Scafir/gf180mcu-project-trident-gf180-teststructure/README.md

<!-- SPDX-FileCopyrightText: 2026 CERN
<!-- SPDX-License-Identifier: CC-BY-4.0 -->

# trident-gf180-teststructures

The aim of this ASIC is to implement teststructures to experimentally measure
leakage for various basic teststructures such as (but not limited to):
* transistors
* MIM capacitors
* ESD protection pads

You can find the datasheet of this chip under `doc/TRIDENT_GF180_teststructures.pdf`.

You may find the upstream location of this repository, as well as others concerning
this ASIC at https://cern.ch/gftrid

ESD protection pads from liplib have been used, available here:
https://github.com/Scafir/liplib

This is an ASIC made through a CERN+JKU PhD collaboration.
