Scafir/gf180mcu-project-trident-gf180-teststructure/doc/figures/BondingDiagramStaggeredv2.png

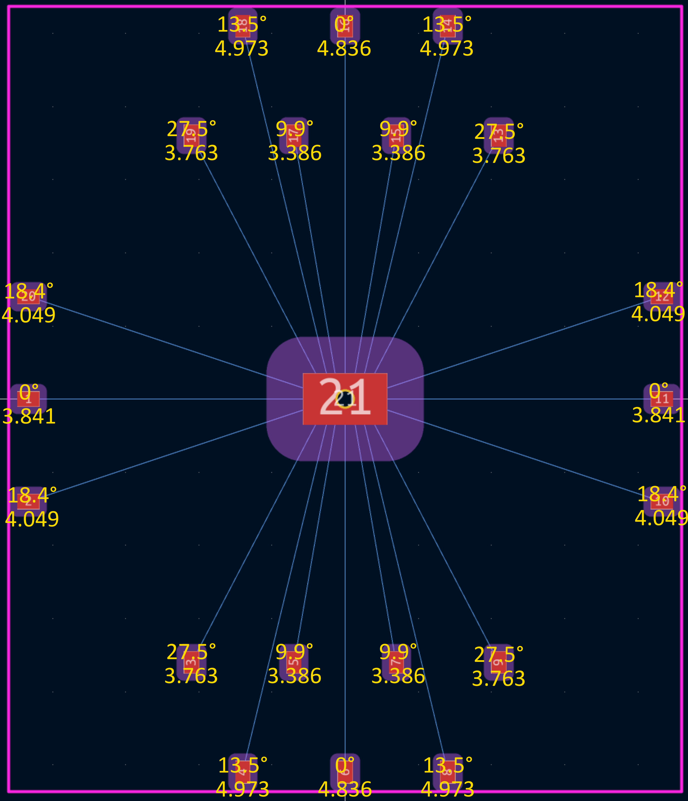
doc/figures/BondingDiagramStaggeredv2.png
