Scafir/gf180mcu-project-trident-gf180-teststructure/doc/TRIDENT_GF180_teststructures.pdf

30 June 2026

## TRIDENT-GF180-TESTSTRUCTURES Datasheet

## 1 Known issues

1. The markings of pin 100, pin 1 and pin 2 are incorrect. Pin 100 marking is actually pin 99. Pin 1 marking is pin 100. Pin 2 marking is pin 1.

## 2 Applications

- Leakage evaluation of GlobalFoundries GF180MCU (gf180mcuD) 180 nm process
- Evaluation of guard-trace effectiveness
- Evaluation of foundry vs. custom guarded ESD pad approaches for ultra-low current measurement
- Characterization of discrete HV/LV NFET and PFET leakage under guarding
- Characterization of MIM capacitor leakage and perimeter effects
- Evaluation of picoampere two-transistor charge-pump / current generator structure

## 3 Description

TRIDENT-GF180-TESTSTRUCTURES is a dedicated test ASIC to assess feasibility of ultralow current (pA and below) measurements in gf180mcuD. It is available open source here. (https://github.com/Scafir/gf180mcu-project-trident-gf180-teststructure) The primary metric is control and predictability of leakage current from “hot” measurement nodes. Primary leakage paths of interest are ESD protection networks, transistor, MIM capacitor, and leakage through insulator mitigated by driven guards.
Pins between structures are often interleaved, to allow for the neighboring pins to be driven as guard. This is especially useful when large voltage between pins are expected on the same device, such as the MIM capacitors.

## 4 Block Diagram

ACCURATE 2A | CERN HSE-RP-IL

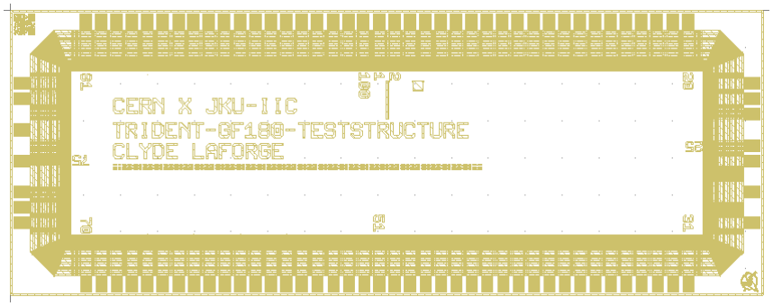
[picture p7: figure]

Figure 1: Top level view of the chip

## 5 Pin Configuration and Function Descriptions

# Pin name | Decription

1 MC MAX P1 | MIM capacitor, max perimeter, terminal P1
2 MC MIN P2 | MIM capacitor, min perimeter, terminal P2
3 MC MIN P1 | MIM capacitor, min perimeter, terminal P1
4–7 UNUSED | Do not connect
8 MC GUARD P2 | Guard for MIM capacitor terminal P2
9–13 UNUSED | Do not connect
14 GL TOP | Guard leakage structure, top guard
15 GL BOT | Guard leakage structure, bottom guard
16 GL SIDE | Guard leakage structure, side guard
17 GL HOT | Guard leakage structure, hot node
18 GL PAD GUARD | Guard leakage structure, guard of hot bondpad
19 VSS | Ground supply
20 VDD | Positive supply
21 PESD GS HOTN | Pad ESD (guard+sense), inverted hot output
22 PESD GS SENSEN Pad ESD (guard+sense), inverted sense output
23 PESD GS SENSE | Pad ESD (guard+sense), sense input
24 NO BOND | No bondpad present, do not bond
25 PESD GS HOT | Pad ESD (guard+sense), hot input
26 NO BOND | No bondpad present, do not bond
27 PESD G HOTN | Pad ESD (guard), inverted hot output
28 NO BOND | No bondpad present, do not bond
29 PESD G HOT | Pad ESD (guard), hot input
30 PESD GUARD | Guard for all PESD structures
31 VSS | Ground supply
32 VDD | Positive supply

33–48 UNUSED | Do not connect
49 DESD VDD K | Discrete ESD diodes to VDD, cathode
50 DESD VSS K | Discrete ESD diodes to VSS, cathode
51 DESD VDD A | Discrete ESD diodes to VDD, anode
52 DESD GUARD | Guard for discrete ESD diode structures
53 VSS | Ground supply
54 VDD | Positive supply
55 TR GUARD | Transistor structures, guard (common)
56 TR HP D | High-voltage PFET, drain
57 TR HP G | High-voltage PFET, gate
58 TR HP S | High-voltage PFET, source
59 TR HN D | High-voltage NFET, drain
60 TR HN G | High-voltage NFET, gate
61 TR HN S | High-voltage NFET, source
62 TR LP D | Low-voltage PFET, drain
63 TR LP G | Low-voltage PFET, gate
64 TR LP S | Low-voltage PFET, source
65 TR LN D | Low-voltage NFET, drain
66 TR LN G | Low-voltage NFET, gate
67 TR LN S | Low-voltage NFET, source
68 TR GUARD | Transistor structures, guard (common)
69 VSS | Ground supply
70 VDD | Positive supply
71 PL GUARD | Pad leakage structure, guard (common)
72 PL FLOAT | Pad leakage structure, floating pad
73 PL GS SENSE | Pad leakage (guard+sense), sense input
74 NO BOND | No bondpad present, do not bond
75 PL GS HOT | Pad leakage (guard+sense), hot input
76 NO BOND | No bondpad present, do not bond
77 PL G HOT | Pad leakage (guard), hot input
78 NO BOND | No bondpad present, do not bond
79 PL A HOT | Pad leakage (analog), hot input
80 PL GUARD | Pad leakage structure, guard (common)
81 VSS | Ground supply
82 VDD | Positive supply
83 CP GUARD | Charge pump structure, guard
84 CP G2 | Charge pump, gate 2
85 CP VS | Charge pump, VS node (drain+source)
86 CP G1 | Charge pump, gate 1
87 CP VW | Charge pump, VW node (bulk)
88–96 UNUSED | Do not connect
97 VSS | Ground supply
98 VDD | Positive supply
99 MC GUARD P1 | Guard for MIM capacitor terminal P1

100 MC MAX P2 | MIM capacitor, max perimeter, terminal P2

UNUSED pads are foundry-provided analog ESD pad with their output left unconnected. NO BOND pads have not actual bondpad implemented. They are missing due to the underlying structures being too large. Instead of simply removing them from lists, they are kept nonetheless so that the pad positions and numbering stays regular.

## 6 ESD protection pads

### 6.1 Foundry provided analog pad

Below is a diagram of the foundry provided analog input pad, which provide a classic protection structure. The input diodes (on the pad side) are very large as they are supposed to take the brunt of the ESD pulses. The series resistor and output diodes are optional: they are not provided within the pad itself, but users are encouraged to add them in the documentation. The value of the series resistor is typically a few hundred ohms. This allow a secondary path for the current in case of an ESD spike, and the series resistor allows for a reduction of the voltage to which the core will be exposed.
This pad has an implementation with no output, to characterize its leakage in ADDREF. It does not have an implementation with output connected to an inverted to determine its capability of protecting the core transistors due to a lack of time during the layout process.

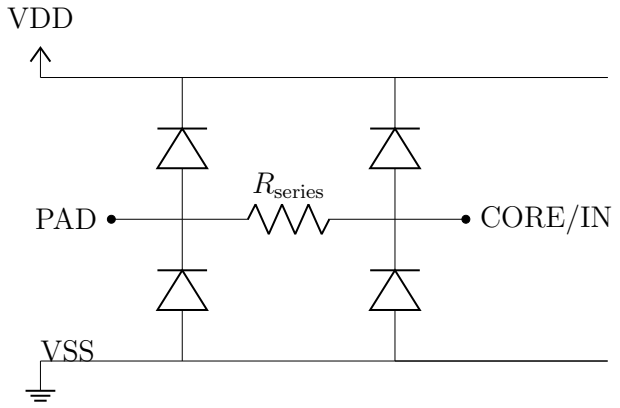
[picture p8: figure]
VDD; VSS; PAD; Rseries; CORE/IN

### 6.2 Custom guard pad

This adds a guard trace around the input trace. This allows for the internal diodes (between PAD and GUARD) to experience a near zero voltage drop, and hence have minimal leakage. The guard voltage could be driven by a buffer connected to the core voltage. It could also be driven independently from the input (if it is at a fixed voltage), and trimmed by-device for a specific operating point, likely temperature.
In order to provide somewhat comparable ESD protection to the foundry provided analog pad, the size of each diode is doubled compared to it.
As the inner VSS diode is not connected directly to VSS, it is necessary to put it in a deep N-well.

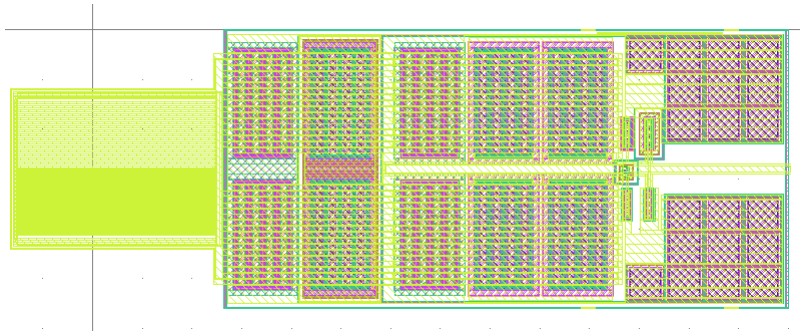
[picture p9: figure]

Figure 2: A graphic representation of the layout of the custom guard pad

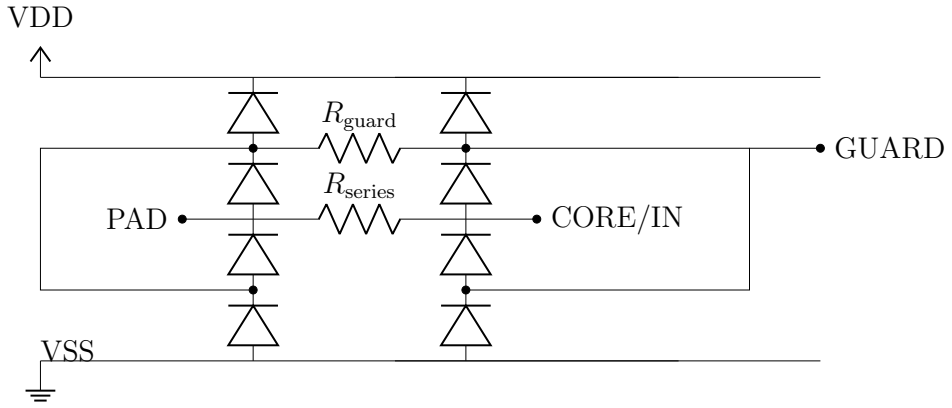
[picture p10: figure]
VDD; VSS; PAD; Rseries; CORE/IN; Rguard; GUARD

### 6.3 Custom guardsense pad

The custom guardsense pad goes one step further than the custom guarded pad. It duplicates the internal components (zero-voltage drop diodes and series resistor), and hence provide 2 new ports, named ”SENSE” and ”CORE SENSE”. Because the implementation of the sense and pad is fully symmetric and interleaved, any leakage experience on the PAD line should be the same on the sense line, provided minimal voltage drop on the series resistor.
This allows for sensing the leakage of the pad input from the core sense. In turn, a the guard voltage can be dynamically adjusted for zero leakage.
For the layout, it was necessary to implement custom ESD diodes, so that it was possible to interleave the guard and hot signals.

### 6.4 Custom no ESD guarded pad

This is simply a bond pad with a guarded metal output. No device whatsoever are connected to the input, which means that it has no ESD protection, but also minimal leakage on its own.

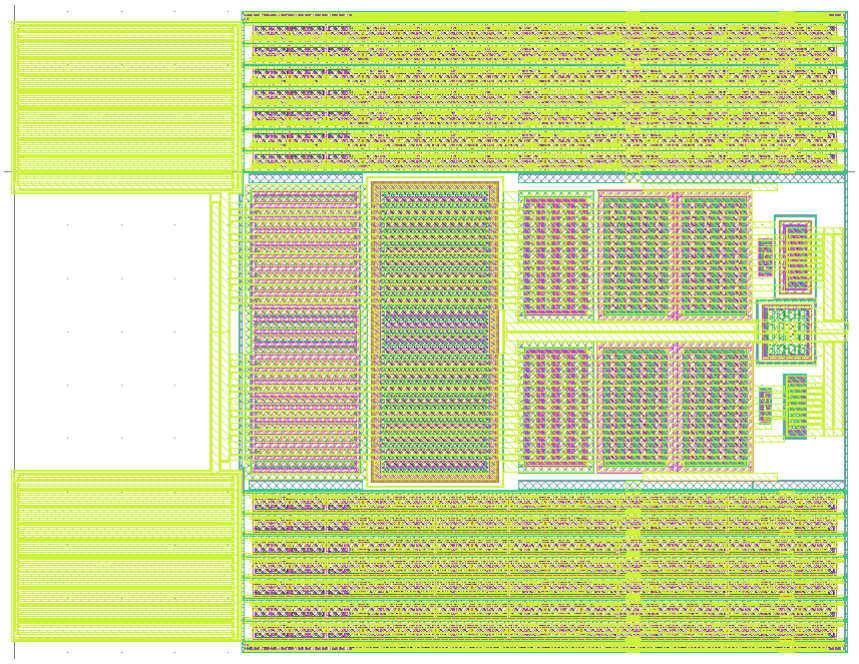
[picture p11: figure]

Figure 3: A graphic representation of the layout of the custom guardsense pad

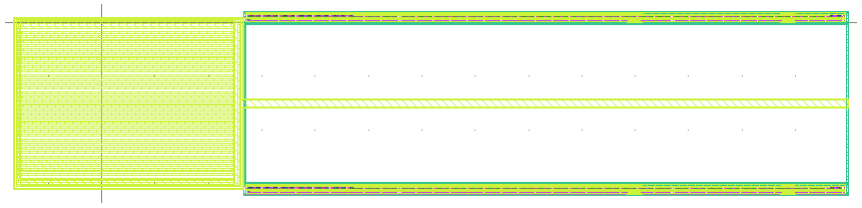
[picture p12: figure]

Figure 4: A graphic representation of the layout of the custom no esd pad

This pad is used anytime there is a device characterization pin, so that the measurement correspond to the actual device, and not the ESD protection circuitry. In order to comply with antenna rules, it has sometime been necessary to route the signal up and down to upper metal layers to comply with antenna rules. An unconnected custom no ESD guarded pad is implemented in 7.9, such that it will be possible to have a reference to other measurements.

## 7 Device Descriptions (by Device)

### 7.1 MIMCAP MAX PERIM

### 7.1.1 Description

MIM capacitor of (256 × 16µm and 8192 fF). Its high perimeter geometry is to study the effect of perimeter in the MIM capacitor leakage. It will be compared against 7.2.

### 7.1.2 Pins (array)

#99, Guard

#100 Pin 2

#1 Pin 1

Pin 1 connects to the lower plate, pin 2 to the upper plate.

### 7.1.3 Diagram

Pin 1

Pin 2

Guard | CMIM ≈ 8192 fF

Figure 5: MIM capacitor (MAX PERIM) with guard.

### 7.2 MIMCAP MIN PERIM

### 7.2.1 Description

MIM capacitor of (64 × 64µm and 8192 fF). Its minimal perimeter geometry is to study the effect of perimeter in the MIM capacitor leakage. It will be compared against 7.1.

### 7.2.2 Pins (array)

#2 Pin 2

#3 Pin 1

#4 Guard

Pin 1 connects to the lower plate, pin 2 to the upper plate.

### 7.2.3 Diagram

Pin 1

Pin 2

Guard | CMIM ≈ 8192 fF

Figure 6: MIM capacitor (MIN PERIM) with guard.

### 7.3 GUARD LEAKAGE

### 7.3.1 Description

This is a guarded line of 1041 × 3 µm in metal XXX. It is guarded independently on the top, bottom and sides. These guard planes can be swept in relation to the hot so that the influence of guarding in silicon can be measured.

### 7.3.2 Pins (array)

#14 Top guard plane

#15 Bottom guard plane

#16 Side guard traces

#17 Hot

#18 Guard of the hot bondpad

### 7.3.3 Diagram

Top guard

Side guard

Hot

Bottom guard

### 7.4 PAD ESD GUARDSENSE

### 7.4.1 Description

Evaluate guard+sense approach and the ability to trim guard voltage using sense leakage. See 6.3 for details on the internal of the guardsense pad. The purpose of the inverters is to measure up to what sort of ESD pulse the gate of the internal low voltage transistors making up the inverters can survive.

### 7.4.2 Pins (array)

#21 Inverted hot output

#22 Inverted sense output

#23 Sense input

#25 Hot input

#30 Guard

### 7.4.3 Diagram

VDD

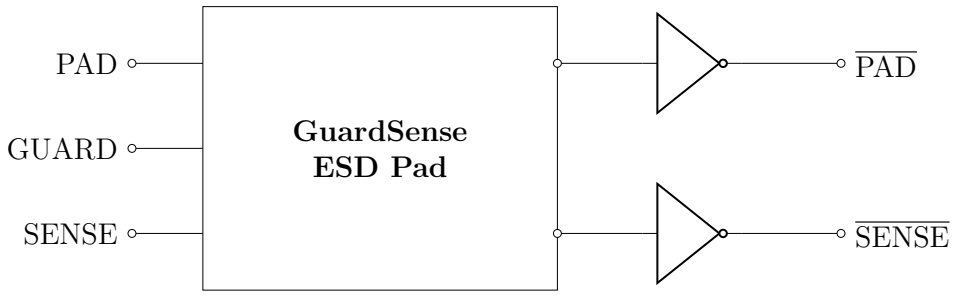
[picture p13: figure]
GuardSense ESD Pad; PAD; SENSE; GUARD

VSS

### 7.5 PAD ESD GUARD

### 7.5.1 Description

Baseline custom guarded ESD pad without sense line. The purpose of the inverter is to evaluate the robustness of the internal low-voltage inverter gate under ESD stress at the pad input.

### 7.5.2 Pins (array)

#27 Inverted hot output

#29 Hot input

#30 Guard

### 7.5.3 Diagram

VDD

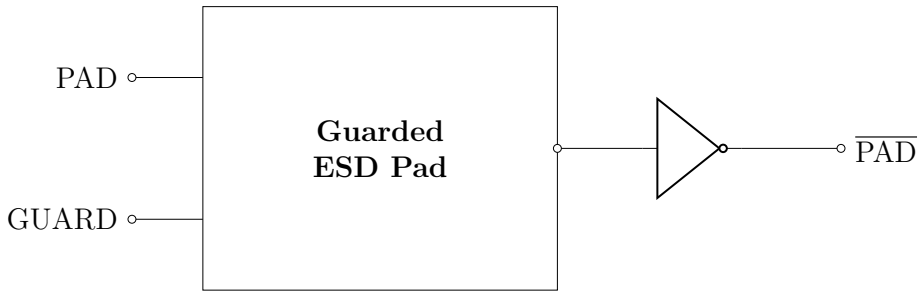
[picture p14: figure]
Guarded ESD Pad; PAD; GUARD

VSS

### 7.6 ESD DIODE VDD

### 7.6.1 Purpose

Standalone foundry-provided vdd esd diode for ultralow current I-V characterization.

### 7.6.2 Pins (array)

#49 Cathode

#51 Anode

#52 Guard

### 7.6.3 Diagram

Anode

Cathode

Guard | VDD ESD diode

### 7.7 ESD DIODE VSS

### 7.7.1 Purpose

Standalone foundry-provided VSS ESD diode for ultralow current I-V characterization. The anode is shorted to VSS through the substrate.

### 7.7.2 Pins (array)

#50 Cathode

#52 Guard

### 7.7.3 Diagram

VSS

Cathode

Guard | VSS ESD diode

### 7.8 Guarded HV/LV NFET/PFET, W=0.75um L=0.7um

### 7.8.1 Description

Direct access to D/G/S for transistor leakage characterization under guarding. No ESD pads were used on signal of interest, but an up and down metal break is made to comply with antenna rules.

### 7.8.2 Pins (array)

Device type Drain Gate Source
HV PFET: | #56 | #57 | #58
HV NFET: | #59 | #60 | #61
LV PFET: | #62 | #63 | #64
LV NFET: | #65 | #66 | #67

Pin #55 and #68 (internally shorted) as used as guard for all transistor structures.

### 7.8.3 Diagram (generic, horizontal MOS symbol)

Drain

Gate

Source

Guard (#55)

Guard (#68)

### 7.9 PAD LEAK EMPTY

### 7.9.1 Description

Custom no ESD bondpad, presented in 6.4 connected to nothing. It will be used as a reference to all other measurement involving this pad.

### 7.9.2 Pins (array)

#71 Guard

#72 Hot

#80 Guard

Guards are internally shorted together.

### 7.9.3 Diagram

Bondpad

GUARD

HOT

GUARD

### 7.10 PAD LEAK GUARDSENSE

### 7.10.1 Purpose

Implements the custom guardsense pad with nothing connected to its output. This allows for measuring the intrinsic leakage of the device. It could also be used for ESD testing, to characterize the robustness of the pad structure itself, as opposed to 7.4, which characterizes its ability to protect the core transistors.

### 7.10.2 Pins (array)

#71 Guard

#73 Sense input

#75 Hot input

#80 Guard

Guards are internally shorted together.

### 7.10.3 Diagram

VDD

VSS

GuardSense
ESD Pad

PAD

SENSE

GUARD

### 7.11 PAD LEAK GUARD

### 7.11.1 Purpose

Implements the custom guard pad with nothing connected to its output. This allows for measuring the intrinsic leakage of the device. It could also be used for ESD testing, to characterize the robustness of the pad structure itself, as opposed to 7.5, which characterizes its ability to protect the core transistors.

### 7.11.2 Pins (array)

#71 Guard

#77 Hot input

#80 Guard

Guards are internally shorted together.

### 7.11.3 Diagram

VDD

VSS

Guarded
ESD Pad

PAD

GUARD

### 7.12 PAD LEAK ASIG

### 7.12.1 Description

Implements the foundry provided analog pad with nothing connected to its output. The bondpad itself is guarded, but the internal structures are not, as they are left untouched. This allows for measuring the intrinsic leakage of the pad. It could also be used for ESD testing, to characterize the robustness of the pad structure itself.

### 7.12.2 Pins (array)

#71 Guard

#77 Hot input

#80 Guard

Guards are internally shorted together.

### 7.12.3 Diagram (abstract, horizontal)

VDD

VSS

Foundry-provided
Analog ESD Pad PAD

GUARD

### 7.13 CHARGE PUMP

### 7.13.1 Purpose

Implements the fifty nifty pico ampere current source.
H. Pretl and M. Eberlein, IEEE SSC Magazine 2021 (DOI: 10.1109/MSSC.2021.3088968); Its operation is described in detail in
U. Cilingiroglu et al., IEEE JSSC 2003 (DOI: 10.1109/JSSC.2002.806282).
Two matched PMOS transistors with separate gates enabling opposite polarity operation to reduce injected noise. Implemented with PMOS W=40 µm, L=1 µm (provided).

### 7.13.2 Pins (array)

#83 Guard

#84 Gate of transistor 2

#85 VS (drain and source of both transistors) #86 Gate of transistor 1

#87 VW (bulk of both transistors)

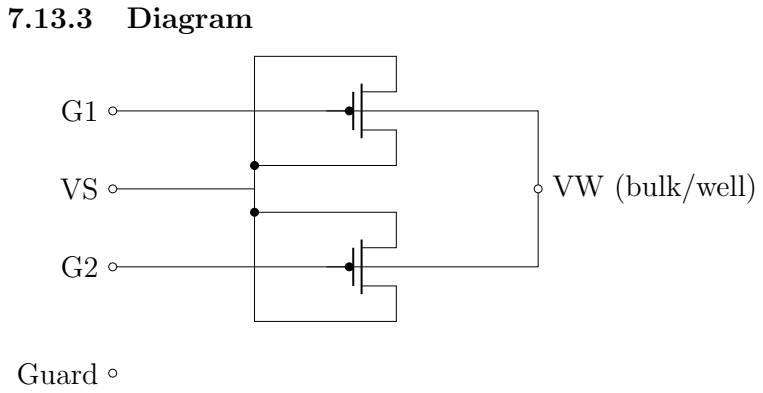
[picture p15: figure]
7.13.3 Diagram; VW (bulk/well); Guard

## 8 Bonding Diagram

### 8.1 Die / Pad Dimensions

The ASIC measures 1936 µm by 5122 µm. Its height is 250 µm.
The bondpads measure 78 µm by 100 µm. Their pitch is 105 µm. The outward edge of the pad is 26 µm away from the sealring.

### 8.2 Bonding Diagram and Recommended PCB Footprint

As the ASIC is composed of many pads, and the ultra-low current nature of the teststructures require a certain spacing between the PCB pads, two bonding diagrams have been made, each one allowing access to a subset of the test structures.


(a) Bonding diagram variant A | (b) Bonding diagram variant B

Figure 7: trident-gf180-teststructures bonding diagrams

# | side bondpad x bondpad y pcbpad x pcbpad y length mm angle [°]

1 | WEST -0.903 | 0.0525 | -6.468 | -0.5 | 5.592359 | -5.67
2 | WEST -0.903 | 0.1575 | -4.968 | 0.1 | 4.065407 | -0.81
3 | WEST -0.903 | 0.2625 | -6.468 | 0.2 | 5.565351 | -0.64
8 | WEST -0.903 | 0.7875 | -4.968 | 0.8 | 4.065019 | 0.18
19 | WEST -0.903 | 1.9425 | -6.468 | 1.6 | 5.57553 | -3.52
20 | WEST -0.903 | 2.0475 | -6.468 | 2 | 5.565203 | -0.49
21 | NORTH -0.4725 | 2.485 | -1.25 | 6.561 | 4.149492 | -10.8
22 | NORTH -0.3675 | 2.485 | -0.85 | 6.561 | 4.104459 | -6.75
23 | NORTH -0.2625 | 2.485 | -0.85 | 8.061 | 5.606865 | -6.01
25 | NORTH -0.0525 | 2.485 | 0.55 | 8.061 | 5.608456 | 6.17
27 | NORTH 0.1575 | 2.485 | 0.55 | 6.561 | 4.094854 | 5.5
29 | NORTH 0.3675 | 2.485 | 1.25 | 8.061 | 5.645404 | 8.99
30 | NORTH 0.4725 | 2.485 | 1.25 | 6.561 | 4.149492 | 10.8
31 | EAST 0.903 | 2.0475 | 6.468 | 2.8 | 5.615646 | -7.7
32 | EAST 0.903 | 1.9425 | 6.468 | 2.4 | 5.583774 | -4.7
49 | EAST 0.903 | 0.1575 | 4.968 | 1.9 | 4.422729 | -23.2
50 | EAST 0.903 | 0.0525 | 4.968 | 1.2 | 4.223859 | -15.76
51 | EAST 0.903 | -0.0525 | 6.468 | 1 | 5.663654 | -10.71
52 | EAST 0.903 | -0.1575 | 4.968 | 0.5 | 4.117831 | -9.19
55 | EAST 0.903 | -0.4725 | 4.968 | 0.1 | 4.105116 | -8.02
56 | EAST 0.903 | -0.5775 | 6.468 | 0.1 | 5.606089 | -6.94
57 | EAST 0.903 | -0.6825 | 4.968 | -0.6 | 4.065837 | -1.16
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
84 | WEST -0.903 | -1.7325 | -4.968 | -2.1 | 4.081578 | -5.17
85 | WEST -0.903 | -1.6275 | -6.468 | -1.3 | 5.574628 | 3.37
86 | WEST -0.903 | -1.5225 | -4.968 | -0.7 | 4.147376 | 11.44
87 | WEST -0.903 | -1.4175 | -6.468 | 0.1 | 5.768191 | 15.25
Figure 9: Bonding wire information for variant B
