Scafir/gf180mcu-project-trident-gf180-teststructure/klayout/top.schematic_lvs.spice

* SPDX-FileCopyrightText: 2026 CERN
* SPDX-License-Identifier: CERN-OHL-W-2.0
** sch_path: /run/host/mainData/cernbox/PhD/gf180mcu-project-trident-gf180-teststructure/xschem/top.sch
**.subckt top lv_nfet_W030L070_source_PAD lv_nfet_W030L070_gate_PAD lv_nfet_W030L070_drain_PAD lv_pfet_W030L070_source_PAD
*+ lv_pfet_W030L070_gate_PAD lv_pfet_W030L070_drain_PAD hv_nfet_W030L070_source_PAD hv_nfet_W030L070_gate_PAD hv_nfet_W030L070_drain_PAD
*+ hv_pfet_W030L070_source_PAD hv_pfet_W030L070_gate_PAD hv_pfet_W030L070_drain_PAD GUARDSENSE_ASIG_PAD GUARDSENSE_SENSE_PAD PAD_GUARD_PAD ASIG_FOUNDRY_PAD
*+ PAD_GUARD_PAD EMPTY_PAD guard_transistors_PAD TOFILL54_PAD TOFILL55_PAD TOFILL56_PAD TOFILL57_PAD TOFILL58_PAD TOFILL59_PAD TOFILL60_PAD
*+ TOFILL61_PAD TOFILL62_PAD TOFILL63_PAD TOFILL23_PAD TOFILL24_PAD TOFILL25_PAD TOFILL26_PAD TOFILL27_PAD TOFILL28_PAD TOFILL29_PAD TOFILL30_PAD
*+ TOFILL31_PAD CHARGE_PUMP_VW_PAD CHARGE_PUMP_G1_PAD CHARGE_PUMP_G2_PAD GUARD_CHARGE_PUMP_PAD TOFILL18_PAD TOFILL17_PAD TOFILL16_PAD
*+ TOFILL15_PAD TOFILL14_PAD TOFILL13_PAD TOFILL12_PAD TOFILL11_PAD TOFILL10_PAD TOFILL9_PAD TOFILL8_PAD TOFILL7_PAD TOFILL6_PAD TOFILL5_PAD
*+ TOFILL4_PAD TOFILL3_PAD TOFILL2_PAD TOFILL1_PAD TOFILL49_PAD TOFILL48_PAD TOFILL47_PAD TOFILL46_PAD TOFILL45_PAD TOFILL44_PAD TOFILL43_PAD
*+ TOFILL42_PAD TOFILL41_PAD TOFILL40_PAD TOFILL39_PAD TOFILL38_PAD TOFILL37_PAD TOFILL36_PAD TOFILL35_PAD TOFILL34_PAD TOFILL33_PAD TOFILL32_PAD
*+ CHARGE_PUMP_VS_PAD ASIG_GUARD_PAD VDD VSS TOFILL19_PAD TOFILL20_PAD TOFILL21_PAD TOFILL22_PAD TOFILL53_PAD TOFILL52_PAD TOFILL51_PAD TOFILL50_PAD
*.iopin lv_nfet_W030L070_source_PAD
*.iopin lv_nfet_W030L070_gate_PAD
*.iopin lv_nfet_W030L070_drain_PAD
*.iopin lv_pfet_W030L070_source_PAD
*.iopin lv_pfet_W030L070_gate_PAD
*.iopin lv_pfet_W030L070_drain_PAD
*.iopin hv_nfet_W030L070_source_PAD
*.iopin hv_nfet_W030L070_gate_PAD
*.iopin hv_nfet_W030L070_drain_PAD
*.iopin hv_pfet_W030L070_source_PAD
*.iopin hv_pfet_W030L070_gate_PAD
*.iopin hv_pfet_W030L070_drain_PAD
*.iopin GUARDSENSE_ASIG_PAD
*.iopin GUARDSENSE_SENSE_PAD
*.iopin PAD_GUARD_PAD
*.iopin ASIG_FOUNDRY_PAD
*.iopin PAD_GUARD_PAD
*.iopin EMPTY_PAD
*.iopin guard_transistors_PAD
*.iopin TOFILL54_PAD
*.iopin TOFILL55_PAD
*.iopin TOFILL56_PAD
*.iopin TOFILL57_PAD
*.iopin TOFILL58_PAD
*.iopin TOFILL59_PAD
*.iopin TOFILL60_PAD
*.iopin TOFILL61_PAD
*.iopin TOFILL62_PAD
*.iopin TOFILL63_PAD
*.iopin TOFILL23_PAD
*.iopin TOFILL24_PAD
*.iopin TOFILL25_PAD
*.iopin TOFILL26_PAD
*.iopin TOFILL27_PAD
*.iopin TOFILL28_PAD
*.iopin TOFILL29_PAD
*.iopin TOFILL30_PAD
*.iopin TOFILL31_PAD
*.iopin CHARGE_PUMP_VW_PAD
*.iopin CHARGE_PUMP_G1_PAD
*.iopin CHARGE_PUMP_G2_PAD
*.iopin GUARD_CHARGE_PUMP_PAD
*.iopin TOFILL18_PAD
*.iopin TOFILL17_PAD
*.iopin TOFILL16_PAD
*.iopin TOFILL15_PAD
*.iopin TOFILL14_PAD
*.iopin TOFILL13_PAD
*.iopin TOFILL12_PAD
*.iopin TOFILL11_PAD
*.iopin TOFILL10_PAD
*.iopin TOFILL9_PAD
*.iopin TOFILL8_PAD
*.iopin TOFILL7_PAD
*.iopin TOFILL6_PAD
*.iopin TOFILL5_PAD
*.iopin TOFILL4_PAD
*.iopin TOFILL3_PAD
*.iopin TOFILL2_PAD
*.iopin TOFILL1_PAD
*.iopin TOFILL49_PAD
*.iopin TOFILL48_PAD
*.iopin TOFILL47_PAD
*.iopin TOFILL46_PAD
*.iopin TOFILL45_PAD
*.iopin TOFILL44_PAD
*.iopin TOFILL43_PAD
*.iopin TOFILL42_PAD
*.iopin TOFILL41_PAD
*.iopin TOFILL40_PAD
*.iopin TOFILL39_PAD
*.iopin TOFILL38_PAD
*.iopin TOFILL37_PAD
*.iopin TOFILL36_PAD
*.iopin TOFILL35_PAD
*.iopin TOFILL34_PAD
*.iopin TOFILL33_PAD
*.iopin TOFILL32_PAD
*.iopin CHARGE_PUMP_VS_PAD
*.iopin ASIG_GUARD_PAD
*.iopin VDD
*.iopin VSS
*.iopin TOFILL19_PAD
*.iopin TOFILL20_PAD
*.iopin TOFILL21_PAD
*.iopin TOFILL22_PAD
*.iopin TOFILL53_PAD
*.iopin TOFILL52_PAD
*.iopin TOFILL51_PAD
*.iopin TOFILL50_PAD
x38 VDD VSS VDD VSS corner
x40 VDD VSS VDD gf180mcu_fd_io__dvss_70x100
x50 VDD VSS VDD VSS gf180mcu_fd_io__fill10
x51 VDD VSS VDD VSS gf180mcu_fd_io__fill10
x52 VDD VSS VDD VSS gf180mcu_fd_io__fill10
x80 VDD VSS VDD VSS gf180mcu_fd_io__fill10
x81 VDD VSS VDD VSS gf180mcu_fd_io__fill10
x82 VDD VSS VDD VSS gf180mcu_fd_io__fill10
x83 VDD VSS VDD VSS gf180mcu_fd_io__fill10
x84 VDD VSS VDD VSS gf180mcu_fd_io__fill10
x85 VDD VSS VDD VSS gf180mcu_fd_io__fill10
x86 VDD VSS VDD VSS gf180mcu_fd_io__fill10
x87 VDD VSS VDD VSS gf180mcu_fd_io__fill10
x88 VDD VSS VDD VSS gf180mcu_fd_io__fill10
x4 VDD VSS VDD VSS gf180mcu_fd_io__fill5
x35 EMPTY_PAD VDD VSS VDD VSS PAD_GUARD_PAD gf180mcu_liplib__no_esd_guarded_pad_70x100
x110 VDD VSS VDD VSS gf180mcu_fd_io__fill10
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
x117 TOFILL41_PAD VDD VSS VDD VSS gf180mcu_fd_io__asig_5p0_70x100
x118 TOFILL40_PAD VDD VSS VDD VSS gf180mcu_fd_io__asig_5p0_70x100
x119 TOFILL39_PAD VDD VSS VDD VSS gf180mcu_fd_io__asig_5p0_70x100
x123 TOFILL38_PAD VDD VSS VDD VSS gf180mcu_fd_io__asig_5p0_70x100
x124 TOFILL37_PAD VDD VSS VDD VSS gf180mcu_fd_io__asig_5p0_70x100
x125 TOFILL36_PAD VDD VSS VDD VSS gf180mcu_fd_io__asig_5p0_70x100
x126 TOFILL35_PAD VDD VSS VDD VSS gf180mcu_fd_io__asig_5p0_70x100
x127 TOFILL34_PAD VDD VSS VDD VSS gf180mcu_fd_io__asig_5p0_70x100
x128 TOFILL33_PAD VDD VSS VDD VSS gf180mcu_fd_io__asig_5p0_70x100
x129 TOFILL32_PAD VDD VSS VDD VSS gf180mcu_fd_io__asig_5p0_70x100
x135 VDD VSS VDD gf180mcu_fd_io__dvss_70x100
x136 VDD VSS VSS gf180mcu_fd_io__dvdd_70x100
x910 VDD VSS VDD VSS gf180mcu_fd_io__fill10
x911 VDD VSS VDD VSS gf180mcu_fd_io__fill10
x912 VDD VSS VDD VSS gf180mcu_fd_io__fill10
x133 GUARD_CHARGE_PUMP_PAD CHARGE_PUMP_VS_PAD CHARGE_PUMP_G1_PAD CHARGE_PUMP_G2_PAD CHARGE_PUMP_VW_PAD
+ matched_interface_trap_charge_pumps
x370 VDD VSS VDD VSS gf180mcu_fd_io__fill10
x371 VDD VSS VDD VSS gf180mcu_fd_io__fill10
x372 VDD VSS VDD VSS gf180mcu_fd_io__fill10
x55 VDD VSS VSS gf180mcu_fd_io__dvdd_70x100
x137 VDD VSS VDD gf180mcu_fd_io__dvss_70x100
x44 GUARDSENSE_SENSE_PAD net2 GUARDSENSE_ASIG_PAD VDD net1 VSS VDD VSS PAD_GUARD_PAD
+ gf180mcu_liplib__asig_guard_sense_5p0_pad_70x100_p105
x36 VDD VSS VDD VSS corner
x72 VDD VSS VDD VSS gf180mcu_fd_io__fill5
x112 VDD VSS VDD VSS gf180mcu_fd_io__fill10
x73 VDD VSS VDD VSS gf180mcu_fd_io__fill5
x900 VDD VSS VDD VSS gf180mcu_fd_io__fill1
x901 VDD VSS VDD VSS gf180mcu_fd_io__fill1
x90 ASIG_GUARD_PAD VDD net3 VSS VDD VSS PAD_GUARD_PAD gf180mcu_liplib__asig_guard_5p0_pad_70x100
* noconn #net3
x100 VDD VSS VDD VSS gf180mcu_fd_io__fill1
x101 VDD VSS VDD VSS gf180mcu_fd_io__fill1
x920 VDD VSS VDD VSS gf180mcu_fd_io__fill10
x921 VDD VSS VDD VSS gf180mcu_fd_io__fill10
x922 VDD VSS VDD VSS gf180mcu_fd_io__fill10
x923 VDD VSS VDD VSS gf180mcu_fd_io__fill10
x924 VDD VSS VDD VSS gf180mcu_fd_io__fill10
x925 VDD VSS VDD VSS gf180mcu_fd_io__fill10
x926 VDD VSS VDD VSS gf180mcu_fd_io__fill10
x927 VDD VSS VDD VSS gf180mcu_fd_io__fill10
x928 VDD VSS VDD VSS gf180mcu_fd_io__fill10
x929 VDD VSS VDD VSS gf180mcu_fd_io__fill10
x3 CHARGE_PUMP_VS_PAD VDD VSS VDD VSS GUARD_CHARGE_PUMP_PAD gf180mcu_liplib__no_esd_guarded_pad_70x100
x57 CHARGE_PUMP_VW_PAD VDD VSS VDD VSS GUARD_CHARGE_PUMP_PAD gf180mcu_liplib__no_esd_guarded_pad_70x100
x60 VDD VSS VDD VSS fill_25
x61 VDD VSS VDD VSS fill_25
x62 VDD VSS VDD VSS fill_25
x63 VDD VSS VDD VSS fill_25
x64 lv_nfet_W030L070_source_PAD VDD VSS VDD VSS guard_transistors_PAD gf180mcu_liplib__no_esd_guarded_pad_70x100
x1 lv_nfet_W030L070_gate_PAD VDD VSS VDD VSS guard_transistors_PAD gf180mcu_liplib__no_esd_guarded_pad_70x100
x6 lv_nfet_W030L070_drain_PAD VDD VSS VDD VSS guard_transistors_PAD gf180mcu_liplib__no_esd_guarded_pad_70x100
x9 lv_pfet_W030L070_source_PAD VDD VSS VDD VSS guard_transistors_PAD gf180mcu_liplib__no_esd_guarded_pad_70x100
x11 lv_pfet_W030L070_gate_PAD VDD VSS VDD VSS guard_transistors_PAD gf180mcu_liplib__no_esd_guarded_pad_70x100
x13 lv_pfet_W030L070_drain_PAD VDD VSS VDD VSS guard_transistors_PAD gf180mcu_liplib__no_esd_guarded_pad_70x100
x16 hv_nfet_W030L070_source_PAD VDD VSS VDD VSS guard_transistors_PAD gf180mcu_liplib__no_esd_guarded_pad_70x100
x18 hv_nfet_W030L070_gate_PAD VDD VSS VDD VSS guard_transistors_PAD gf180mcu_liplib__no_esd_guarded_pad_70x100
x21 hv_nfet_W030L070_drain_PAD VDD VSS VDD VSS guard_transistors_PAD gf180mcu_liplib__no_esd_guarded_pad_70x100
x23 hv_pfet_W030L070_source_PAD VDD VSS VDD VSS guard_transistors_PAD gf180mcu_liplib__no_esd_guarded_pad_70x100
x25 hv_pfet_W030L070_gate_PAD VDD VSS VDD VSS guard_transistors_PAD gf180mcu_liplib__no_esd_guarded_pad_70x100
x29 hv_pfet_W030L070_drain_PAD VDD VSS VDD VSS guard_transistors_PAD gf180mcu_liplib__no_esd_guarded_pad_70x100
x31 VDD VSS VDD VSS fill_25
x65 VDD VSS VDD VSS fill_25
x70 VDD VSS VDD VSS gf180mcu_fd_io__fill10
x71 VDD VSS VDD VSS gf180mcu_fd_io__fill10
x150 VDD VSS VDD VSS gf180mcu_fd_io__fill10
x151 VDD VSS VDD VSS gf180mcu_fd_io__fill10
x170 VDD VSS VDD VSS gf180mcu_fd_io__fill10
x171 VDD VSS VDD VSS gf180mcu_fd_io__fill10
x180 VDD VSS VDD VSS gf180mcu_fd_io__fill10
x181 VDD VSS VDD VSS gf180mcu_fd_io__fill10
x190 VDD VSS VDD VSS gf180mcu_fd_io__fill10
x191 VDD VSS VDD VSS gf180mcu_fd_io__fill10
x200 VDD VSS VDD VSS gf180mcu_fd_io__fill10
x201 VDD VSS VDD VSS gf180mcu_fd_io__fill10
x210 VDD VSS VDD VSS gf180mcu_fd_io__fill10
x211 VDD VSS VDD VSS gf180mcu_fd_io__fill10
x220 VDD VSS VDD VSS gf180mcu_fd_io__fill10
x221 VDD VSS VDD VSS gf180mcu_fd_io__fill10
x230 VDD VSS VDD VSS gf180mcu_fd_io__fill10
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
**** begin user architecture code


* INCLUDING NOW
.include $::GF180MCU_FD_IO_PAD_70x100_SPICE
.include $::GF180MCU_FD_IO_SPICE


**** end user architecture code
**.ends

* expanding   symbol:  corner.sym # of pins=4
** sym_path: /run/host/mainData/cernbox/PhD/gf180mcu-project-trident-gf180-teststructure/xschem/corner.sym
** sch_path: /run/host/mainData/cernbox/PhD/gf180mcu-project-trident-gf180-teststructure/xschem/corner.sch
.subckt corner DVDD DVSS VDD VSS
*.iopin VSS
*.iopin VDD
*.iopin DVSS
*.iopin DVDD
x11 DVDD DVSS VDD VSS gf180mcu_fd_io__fill5
x70 DVDD DVSS VDD VSS gf180mcu_fd_io__fill1
x71 DVDD DVSS VDD VSS gf180mcu_fd_io__fill1
x100 DVDD DVSS VDD VSS gf180mcu_fd_io__fill10
x101 DVDD DVSS VDD VSS gf180mcu_fd_io__fill10
x102 DVDD DVSS VDD VSS gf180mcu_fd_io__fill10
x103 DVDD DVSS VDD VSS gf180mcu_fd_io__fill10
x104 DVDD DVSS VDD VSS gf180mcu_fd_io__fill10
x24 DVDD DVSS VDD VSS gf180mcu_fd_io__fill5
x1 DVDD DVSS VDD VSS gf180mcu_fd_io__cor
x20 DVDD DVSS VDD VSS gf180mcu_fd_io__fill10
x21 DVDD DVSS VDD VSS gf180mcu_fd_io__fill10
x22 DVDD DVSS VDD VSS gf180mcu_fd_io__fill10
.ends


* expanding   symbol:  gf180mcu_liplib__no_esd_guarded_pad_70x100.sym # of pins=7
** sym_path: /home/clyde/Documents/liplib/gf180mcuD/xschem/gf180mcu_liplib__no_esd_guarded_pad_70x100.sym
** sch_path: /home/clyde/Documents/liplib/gf180mcuD/xschem/gf180mcu_liplib__no_esd_guarded_pad_70x100.sch
.subckt gf180mcu_liplib__no_esd_guarded_pad_70x100 pad DVDD DVSS VDD VSS pad_guard
*.iopin pad
*.iopin pad_guard
*.iopin DVDD
*.iopin DVSS
*.iopin VDD
*.iopin VSS
* noconn DVDD
* noconn pad_guard
* noconn pad
* noconn DVSS
*  C1 -  cap_nmos_06v0  IS MISSING !!!!
.ends


* expanding   symbol:  matched_interface_trap_charge_pumps.sym # of pins=5
** sym_path: /run/host/mainData/cernbox/PhD/gf180mcu-project-trident-gf180-teststructure/xschem/matched_interface_trap_charge_pumps.sym
** sch_path: /run/host/mainData/cernbox/PhD/gf180mcu-project-trident-gf180-teststructure/xschem/matched_interface_trap_charge_pumps.sch
.subckt matched_interface_trap_charge_pumps guard V_S V_G1 V_G2 V_W
*.iopin guard
*.iopin V_W
*.iopin V_S
*.iopin V_G1
*.iopin V_G2
*  M1 -  pfet_03v3  IS MISSING !!!!
*  M2 -  pfet_03v3  IS MISSING !!!!
* noconn guard
*  M3 -  pfet_03v3  IS MISSING !!!!
.ends


* expanding   symbol:  gf180mcu_liplib__asig_guard_sense_5p0_pad_70x100_p105.sym # of pins=9
** sym_path: /home/clyde/Documents/liplib/gf180mcuD/xschem/gf180mcu_liplib__asig_guard_sense_5p0_pad_70x100_p105.sym
** sch_path: /home/clyde/Documents/liplib/gf180mcuD/xschem/gf180mcu_liplib__asig_guard_sense_5p0_pad_70x100_p105.sch
.subckt gf180mcu_liplib__asig_guard_sense_5p0_pad_70x100_p105 sense sense_res pad DVDD pad_res DVSS VDD VSS pad_guard
*.iopin pad
*.iopin pad_guard
*.iopin DVDD
*.iopin DVSS
*.iopin pad_res
*.iopin sense
*.iopin sense_res
*.iopin VDD
*.iopin VSS
*  D1 -  diode_nd2ps_06v0  IS MISSING !!!!
*  D2 -  diode_nd2ps_06v0  IS MISSING !!!!
*  D3 -  diode_pd2nw_06v0  IS MISSING !!!!
*  D4 -  diode_pd2nw_06v0  IS MISSING !!!!
*  R1 -  ppolyf_u_1k  IS MISSING !!!!
*  D5 -  diode_pd2nw_06v0  IS MISSING !!!!
*  D6 -  diode_nd2ps_06v0  IS MISSING !!!!
*  D7 -  diode_nd2ps_06v0  IS MISSING !!!!
*  D8 -  diode_nd2ps_06v0  IS MISSING !!!!
*  D9 -  diode_pd2nw_06v0  IS MISSING !!!!
*  R2 -  ppolyf_u_1k  IS MISSING !!!!
*  D10 -  diode_pd2nw_06v0  IS MISSING !!!!
*  D11 -  diode_nd2ps_06v0  IS MISSING !!!!
*  D14 -  diode_pd2nw_06v0  IS MISSING !!!!
*  D15 -  diode_pd2nw_06v0  IS MISSING !!!!
*  D12 -  diode_nd2ps_06v0  IS MISSING !!!!
*  D13 -  diode_pd2nw_06v0  IS MISSING !!!!
*  R5 -  ppolyf_u_1k  IS MISSING !!!!
*  C1 -  cap_nmos_06v0  IS MISSING !!!!
*  C2 -  cap_nmos_06v0  IS MISSING !!!!
*  R3 -  ppolyf_u_1k  IS MISSING !!!!
*  D16 -  diode_nd2ps_06v0  IS MISSING !!!!
*  D17 -  diode_pd2nw_06v0  IS MISSING !!!!
.ends


* expanding   symbol:  gf180mcu_liplib__asig_guard_5p0_pad_70x100.sym # of pins=7
** sym_path: /home/clyde/Documents/liplib/gf180mcuD/xschem/gf180mcu_liplib__asig_guard_5p0_pad_70x100.sym
** sch_path: /home/clyde/Documents/liplib/gf180mcuD/xschem/gf180mcu_liplib__asig_guard_5p0_pad_70x100.sch
.subckt gf180mcu_liplib__asig_guard_5p0_pad_70x100 pad DVDD pad_res DVSS VDD VSS pad_guard
*.iopin pad
*.iopin pad_guard
*.iopin DVDD
*.iopin DVSS
*.iopin pad_res
*.iopin VDD
*.iopin VSS
*  D1 -  diode_nd2ps_06v0  IS MISSING !!!!
*  D2 -  diode_nd2ps_06v0  IS MISSING !!!!
*  D3 -  diode_pd2nw_06v0  IS MISSING !!!!
*  D4 -  diode_pd2nw_06v0  IS MISSING !!!!
*  D7 -  diode_nd2ps_06v0  IS MISSING !!!!
*  C1 -  cap_nmos_06v0  IS MISSING !!!!
*  D16 -  diode_nd2ps_06v0  IS MISSING !!!!
*  D17 -  diode_pd2nw_06v0  IS MISSING !!!!
*  D6 -  diode_nd2ps_06v0  IS MISSING !!!!
*  D5 -  diode_pd2nw_06v0  IS MISSING !!!!
*  R3 -  ppolyf_u_1k_6p0  IS MISSING !!!!
*  R1 -  ppolyf_u_1k_6p0  IS MISSING !!!!
* noconn VDD
* noconn VSS
.ends


* expanding   symbol:  fill_25.sym # of pins=4
** sym_path: /run/host/mainData/cernbox/PhD/gf180mcu-project-trident-gf180-teststructure/xschem/fill_25.sym
** sch_path: /run/host/mainData/cernbox/PhD/gf180mcu-project-trident-gf180-teststructure/xschem/fill_25.sch
.subckt fill_25 DVDD DVSS VDD VSS
*.iopin VSS
*.iopin VDD
*.iopin DVSS
*.iopin DVDD
x30 DVDD DVSS VDD VSS gf180mcu_fd_io__fill10
x31 DVDD DVSS VDD VSS gf180mcu_fd_io__fill10
x24 DVDD DVSS VDD VSS gf180mcu_fd_io__fill5
.ends


* expanding   symbol:  lv_nfet_W075L070.sym # of pins=5
** sym_path: /run/host/mainData/cernbox/PhD/gf180mcu-project-trident-gf180-teststructure/xschem/lv_nfet_W075L070.sym
** sch_path: /run/host/mainData/cernbox/PhD/gf180mcu-project-trident-gf180-teststructure/xschem/lv_nfet_W075L070.sch
.subckt lv_nfet_W075L070 guard drain gate source VSS
*.iopin drain
*.iopin gate
*.iopin source
*.iopin VSS
*.iopin guard
*  M1 -  nfet_03v3  IS MISSING !!!!
* noconn guard
.ends


* expanding   symbol:  lv_pfet_W075L070.sym # of pins=5
** sym_path: /run/host/mainData/cernbox/PhD/gf180mcu-project-trident-gf180-teststructure/xschem/lv_pfet_W075L070.sym
** sch_path: /run/host/mainData/cernbox/PhD/gf180mcu-project-trident-gf180-teststructure/xschem/lv_pfet_W075L070.sch
.subckt lv_pfet_W075L070 guard drain gate source VDD
*.iopin drain
*.iopin gate
*.iopin source
*.iopin VDD
*.iopin guard
*  M1 -  pfet_03v3  IS MISSING !!!!
* noconn guard
.ends


* expanding   symbol:  hv_nfet_W075L070.sym # of pins=5
** sym_path: /run/host/mainData/cernbox/PhD/gf180mcu-project-trident-gf180-teststructure/xschem/hv_nfet_W075L070.sym
** sch_path: /run/host/mainData/cernbox/PhD/gf180mcu-project-trident-gf180-teststructure/xschem/hv_nfet_W075L070.sch
.subckt hv_nfet_W075L070 guard drain gate source VSS
*.iopin drain
*.iopin gate
*.iopin source
*.iopin VSS
*.iopin guard
*  M1 -  nfet_06v0  IS MISSING !!!!
* noconn guard
.ends
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
