Scafir/gf180mcu-project-trident-gf180-teststructure/xschem/gf180mcu_fd_io_70x100.spice

* SPDX-FileCopyrightText: 2022 GlobalFoundries PDK Authors
* SPDX-License-Identifier: Apache-2.0


* Copyright 2022 GlobalFoundries PDK Authors
*
* Licensed under the Apache License, Version 2.0 (the "License");
* you may not use this file except in compliance with the License.
* You may obtain a copy of the License at
*
*     http://www.apache.org/licenses/LICENSE-2.0
*
* Unless required by applicable law or agreed to in writing, software
* distributed under the License is distributed on an "AS IS" BASIS,
* WITHOUT WARRANTIES OR CONDITIONS OF ANY KIND, either express or implied.
* See the License for the specific language governing permissions and
* limitations under the License.

.SUBCKT gf180mcu_fd_io__asig_5p0_70x100 ASIG5V DVDD DVSS VDD VSS
D0 DVSS DVDD diode_nd2ps_06v0 m=4.0 area=40e-12 pj=82e-6
X1 DVDD DVSS cap_nmos_06v0 m=36.0 c_length=15e-6 c_width=15e-6
D2 DVSS ASIG5V diode_nd2ps_06v0 m=4.0 area=150e-12 pj=106e-6
D3 ASIG5V DVDD diode_pd2nw_06v0 m=4.0 area=150e-12 pj=106e-6
.ENDS


******* EOF

* Copyright 2022 GlobalFoundries PDK Authors
*
* Licensed under the Apache License, Version 2.0 (the "License");
* you may not use this file except in compliance with the License.
* You may obtain a copy of the License at
*
*     http://www.apache.org/licenses/LICENSE-2.0
*
* Unless required by applicable law or agreed to in writing, software
* distributed under the License is distributed on an "AS IS" BASIS,
* WITHOUT WARRANTIES OR CONDITIONS OF ANY KIND, either express or implied.
* See the License for the specific language governing permissions and
* limitations under the License.

.SUBCKT gf180mcu_fd_io__bi_24t_70x100 A CS DVDD DVSS IE OE PAD PD PU SL VDD VSS Y
X0 n9 VDD VDD ppolyf_u r_width=800e-9 r_length=1.6e-6 m=1.0 r=907.859 par=1
X1 n11 VDD VDD ppolyf_u r_width=800e-9 r_length=1.6e-6 m=1.0 r=907.859 par=1
X2 DVDD DVSS cap_nmos_06v0 m=4.0 c_length=3e-6 c_width=3e-6
X3 DVDD DVSS cap_nmos_06v0 m=8.0 c_length=1.5e-6 c_width=5e-6
X4 n43 n32 DVSS DVSS nfet_06v0 m=1.0 w=3e-6 l=700e-9 nf=2.0 as=1.32e-12 ad=780e-15
+ ps=7.76e-6 pd=4.04e-6 nrd=86.667e-3 nrs=146.667e-3 sa=440e-9 sb=440e-9
+ sd=520e-9 dtemp=0.0 par=1
X5 n56 IE VSS VSS nfet_06v0 m=1.0 w=1.5e-6 l=700e-9 nf=1.0 as=660e-15 ad=660e-15
+ ps=3.88e-6 pd=3.88e-6 nrd=293.333e-3 nrs=293.333e-3 sa=440e-9 sb=440e-9
+ sd=0.0 dtemp=0.0 par=1
X6 n32 n56 DVSS DVSS nfet_06v0 m=1.0 w=3e-6 l=700e-9 nf=2.0 as=1.32e-12 ad=780e-15
+ ps=7.76e-6 pd=4.04e-6 nrd=86.667e-3 nrs=146.667e-3 sa=440e-9 sb=440e-9
+ sd=520e-9 dtemp=0.0 par=1
X7 n43 n32 DVDD DVDD pfet_06v0 m=1.0 w=6e-6 l=700e-9 nf=2.0 as=2.64e-12 ad=1.56e-12
+ ps=13.76e-6 pd=7.04e-6 nrd=43.333e-3 nrs=73.333e-3 sa=440e-9 sb=440e-9
+ sd=520e-9 dtemp=0.0 par=1
X8 n56 IE VDD VDD pfet_06v0 m=1.0 w=3e-6 l=700e-9 nf=1.0 as=1.32e-12 ad=1.32e-12
+ ps=6.88e-6 pd=6.88e-6 nrd=146.667e-3 nrs=146.667e-3 sa=440e-9 sb=440e-9
+ sd=0.0 dtemp=0.0 par=1
X9 n32 n56 DVDD DVDD pfet_06v0 m=1.0 w=6e-6 l=700e-9 nf=2.0 as=2.64e-12 ad=1.56e-12
+ ps=13.76e-6 pd=7.04e-6 nrd=43.333e-3 nrs=73.333e-3 sa=440e-9 sb=440e-9
+ sd=520e-9 dtemp=0.0 par=1
X10 n49 n33 DVSS DVSS nfet_06v0 m=1.0 w=3e-6 l=700e-9 nf=2.0 as=1.32e-12 ad=780e-15
+ ps=7.76e-6 pd=4.04e-6 nrd=86.667e-3 nrs=146.667e-3 sa=440e-9 sb=440e-9
+ sd=520e-9 dtemp=0.0 par=1
X11 n64 CS VSS VSS nfet_06v0 m=1.0 w=1.5e-6 l=700e-9 nf=1.0 as=660e-15
+ ad=660e-15 ps=3.88e-6 pd=3.88e-6 nrd=293.333e-3 nrs=293.333e-3 sa=440e-9
+ sb=440e-9 sd=0.0 dtemp=0.0 par=1
X12 n33 n64 DVSS DVSS nfet_06v0 m=1.0 w=3e-6 l=700e-9 nf=2.0 as=1.32e-12 ad=780e-15
+ ps=7.76e-6 pd=4.04e-6 nrd=86.667e-3 nrs=146.667e-3 sa=440e-9 sb=440e-9
+ sd=520e-9 dtemp=0.0 par=1
X13 n49 n33 DVDD DVDD pfet_06v0 m=1.0 w=6e-6 l=700e-9 nf=2.0 as=2.64e-12
+ ad=1.56e-12 ps=13.76e-6 pd=7.04e-6 nrd=43.333e-3 nrs=73.333e-3 sa=440e-9
+ sb=440e-9 sd=520e-9 dtemp=0.0 par=1
X14 n64 CS VDD VDD pfet_06v0 m=1.0 w=3e-6 l=700e-9 nf=1.0 as=1.32e-12
+ ad=1.32e-12 ps=6.88e-6 pd=6.88e-6 nrd=146.667e-3 nrs=146.667e-3 sa=440e-9
+ sb=440e-9 sd=0.0 dtemp=0.0 par=1
X15 n33 n64 DVDD DVDD pfet_06v0 m=1.0 w=6e-6 l=700e-9 nf=2.0 as=2.64e-12
+ ad=1.56e-12 ps=13.76e-6 pd=7.04e-6 nrd=43.333e-3 nrs=73.333e-3 sa=440e-9
+ sb=440e-9 sd=520e-9 dtemp=0.0 par=1
X16 n47 n35 DVSS DVSS nfet_06v0 m=1.0 w=3e-6 l=700e-9 nf=2.0 as=1.32e-12 ad=780e-15
+ ps=7.76e-6 pd=4.04e-6 nrd=86.667e-3 nrs=146.667e-3 sa=440e-9 sb=440e-9
+ sd=520e-9 dtemp=0.0 par=1
X17 n72 n36 VSS VSS nfet_06v0 m=1.0 w=1.5e-6 l=700e-9 nf=1.0 as=660e-15
+ ad=660e-15 ps=3.88e-6 pd=3.88e-6 nrd=293.333e-3 nrs=293.333e-3 sa=440e-9
+ sb=440e-9 sd=0.0 dtemp=0.0 par=1
X18 n35 n72 DVSS DVSS nfet_06v0 m=1.0 w=3e-6 l=700e-9 nf=2.0 as=1.32e-12 ad=780e-15
+ ps=7.76e-6 pd=4.04e-6 nrd=86.667e-3 nrs=146.667e-3 sa=440e-9 sb=440e-9
+ sd=520e-9 dtemp=0.0 par=1
X19 n47 n35 DVDD DVDD pfet_06v0 m=1.0 w=6e-6 l=700e-9 nf=2.0 as=2.64e-12
+ ad=1.56e-12 ps=13.76e-6 pd=7.04e-6 nrd=43.333e-3 nrs=73.333e-3 sa=440e-9
+ sb=440e-9 sd=520e-9 dtemp=0.0 par=1
X20 n72 n36 VDD VDD pfet_06v0 m=1.0 w=3e-6 l=700e-9 nf=1.0 as=1.32e-12
+ ad=1.32e-12 ps=6.88e-6 pd=6.88e-6 nrd=146.667e-3 nrs=146.667e-3 sa=440e-9
+ sb=440e-9 sd=0.0 dtemp=0.0 par=1
X21 n35 n72 DVDD DVDD pfet_06v0 m=1.0 w=6e-6 l=700e-9 nf=2.0 as=2.64e-12
+ ad=1.56e-12 ps=13.76e-6 pd=7.04e-6 nrd=43.333e-3 nrs=73.333e-3 sa=440e-9
+ sb=440e-9 sd=520e-9 dtemp=0.0 par=1
X22 n51 n38 DVSS DVSS nfet_06v0 m=1.0 w=3e-6 l=700e-9 nf=2.0 as=1.32e-12 ad=780e-15
+ ps=7.76e-6 pd=4.04e-6 nrd=86.667e-3 nrs=146.667e-3 sa=440e-9 sb=440e-9
+ sd=520e-9 dtemp=0.0 par=1
X23 n80 n34 VSS VSS nfet_06v0 m=1.0 w=1.5e-6 l=700e-9 nf=1.0 as=660e-15
+ ad=660e-15 ps=3.88e-6 pd=3.88e-6 nrd=293.333e-3 nrs=293.333e-3 sa=440e-9
+ sb=440e-9 sd=0.0 dtemp=0.0 par=1
X24 n38 n80 DVSS DVSS nfet_06v0 m=1.0 w=3e-6 l=700e-9 nf=2.0 as=1.32e-12 ad=780e-15
+ ps=7.76e-6 pd=4.04e-6 nrd=86.667e-3 nrs=146.667e-3 sa=440e-9 sb=440e-9
+ sd=520e-9 dtemp=0.0 par=1
X25 n51 n38 DVDD DVDD pfet_06v0 m=1.0 w=6e-6 l=700e-9 nf=2.0 as=2.64e-12
+ ad=1.56e-12 ps=13.76e-6 pd=7.04e-6 nrd=43.333e-3 nrs=73.333e-3 sa=440e-9
+ sb=440e-9 sd=520e-9 dtemp=0.0 par=1
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
+ sb=440e-9 sd=0.0 dtemp=0.0 par=1
X177 n338 n153 DVDD DVDD pfet_06v0 m=1.0 w=12e-6 l=700e-9 nf=1.0 as=5.28e-12
+ ad=5.28e-12 ps=24.88e-6 pd=24.88e-6 nrd=36.667e-3 nrs=36.667e-3 sa=440e-9
+ sb=440e-9 sd=0.0 dtemp=0.0 par=1
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
