Scafir/gf180mcu-project-trident-gf180-teststructure/(commit log)

2025-11-13 WIP ongoing work on guarded pad
    [gf180mcu_fd_io__asig_guard_5p0_70x100.sch]
2025-11-14 guarded pad drc and lvs clean
    [gf180mcu_fd_io__asig_guard_5p0_70x100.sch]
2025-11-20 guard_sense_pad: initial commit
    [gf180mcu_fd_io__asig_guard_sense_5p0_70x100.sch]
2025-11-24 klayout/xschem: transistors test structures pass drc+lvs
    [hv_nfet_W030L070.sch, hv_pfet_W030L070.sch, lv_nfet_W030L070.sch, lv_pfet_W030L070.sch]
2025-11-25 xschem lv_pfet hv_pfet correct pin name
    [hv_pfet_W030L070.sch, lv_pfet_W030L070.sch]
2025-11-25 xschem asig_guard add digital and analog supply pin
    [gf180mcu_fd_io__asig_guard_5p0_70x100.sch]
2025-12-02 top chip passes DRC, LVS test mostly ready
    [corner.sch, hv_nfet_W030L070.sch, hv_pfet_W030L070.sch, interface_trap_charge_pump_cascode.sch, lv_nfet_W030L070.sch, lv_pfet_W030L070.sch, matched_interface_trap_charge_pumps.sch, top.sch]
2025-12-02 remove deprecated devices
    [gf180mcu_fd_io__asig_guard_5p0_70x100.sch, gf180mcu_fd_io__asig_guard_sense_5p0_70x100.sch]
2025-12-03 xschem: complete top level modelling LVS PASS!
    [corner.sch, fill_25.sch, top.sch]
2025-12-03 gf180mcu_fd_io_pad_70x100.gds: add LVWELL so that diodes are recognized, ISOSUB
2025-12-03 Passes Antenna checks
    [hv_nfet_W030L070.sch, hv_nfet_W075L070.sch, hv_pfet_W030L070.sch, hv_pfet_W075L070.sch, lv_nfet_W030L070.sch, lv_nfet_W075L070.sch, lv_pfet_W030L070.sch, lv_pfet_W075L070.sch]
2025-12-03 fixed a couple klayout issue, only revealed through running the pyhton script
2025-12-03 fixed a couple klayout issue, only revealed through running the pyhton script, not GUI
2025-12-04 one can dream
    [top.sch]
2025-12-04 add individual esd diodes and mim cap
    [top.sch]
2025-12-04 all I want klayout DRC clean (LVS pass)
    [top.sch]
2025-12-04 fix small typo in top.sch
    [top.sch]
2025-12-04 Add .sch hv inverter W075L070 that I forgot
    [hv_inverter_W075L070.sch]
2025-12-10 Corrected new DRC rules, added guarding test structure
    [top.sch]
2025-12-15 Fix last antenna drc error
    [hv_nfet_W0160L070.sch, hv_pfet_W160L070.sch, lv_nfet_W160L070.sch, lv_pfet_W160L070.sch, top.sch]
2025-12-15 LVS clean: I swapped 2 nets in the sch, no fix in layout required
    [top.sch]
2026-06-30 all: Implement REUSE
    [corner.sch, fill_25.sch, hv_inverter_W075L070.sch, hv_nfet_W0160L070.sch, hv_pfet_W160L070.sch, interface_trap_charge_pump_cascode.sch, lv_nfet_W160L070.sch, lv_pfet_W160L070.sch]
2026-07-01 top.sch: update notice
    [top.sch]
2026-07-01 all: attribute copyright to CERN
    [corner.sch, fill_25.sch, hv_inverter_W075L070.sch, hv_nfet_W0160L070.sch, hv_pfet_W160L070.sch, interface_trap_charge_pump_cascode.sch, lv_nfet_W160L070.sch, lv_pfet_W160L070.sch]
